mohnsolo/tap-tempo/tap-tempo-schematic.pdf

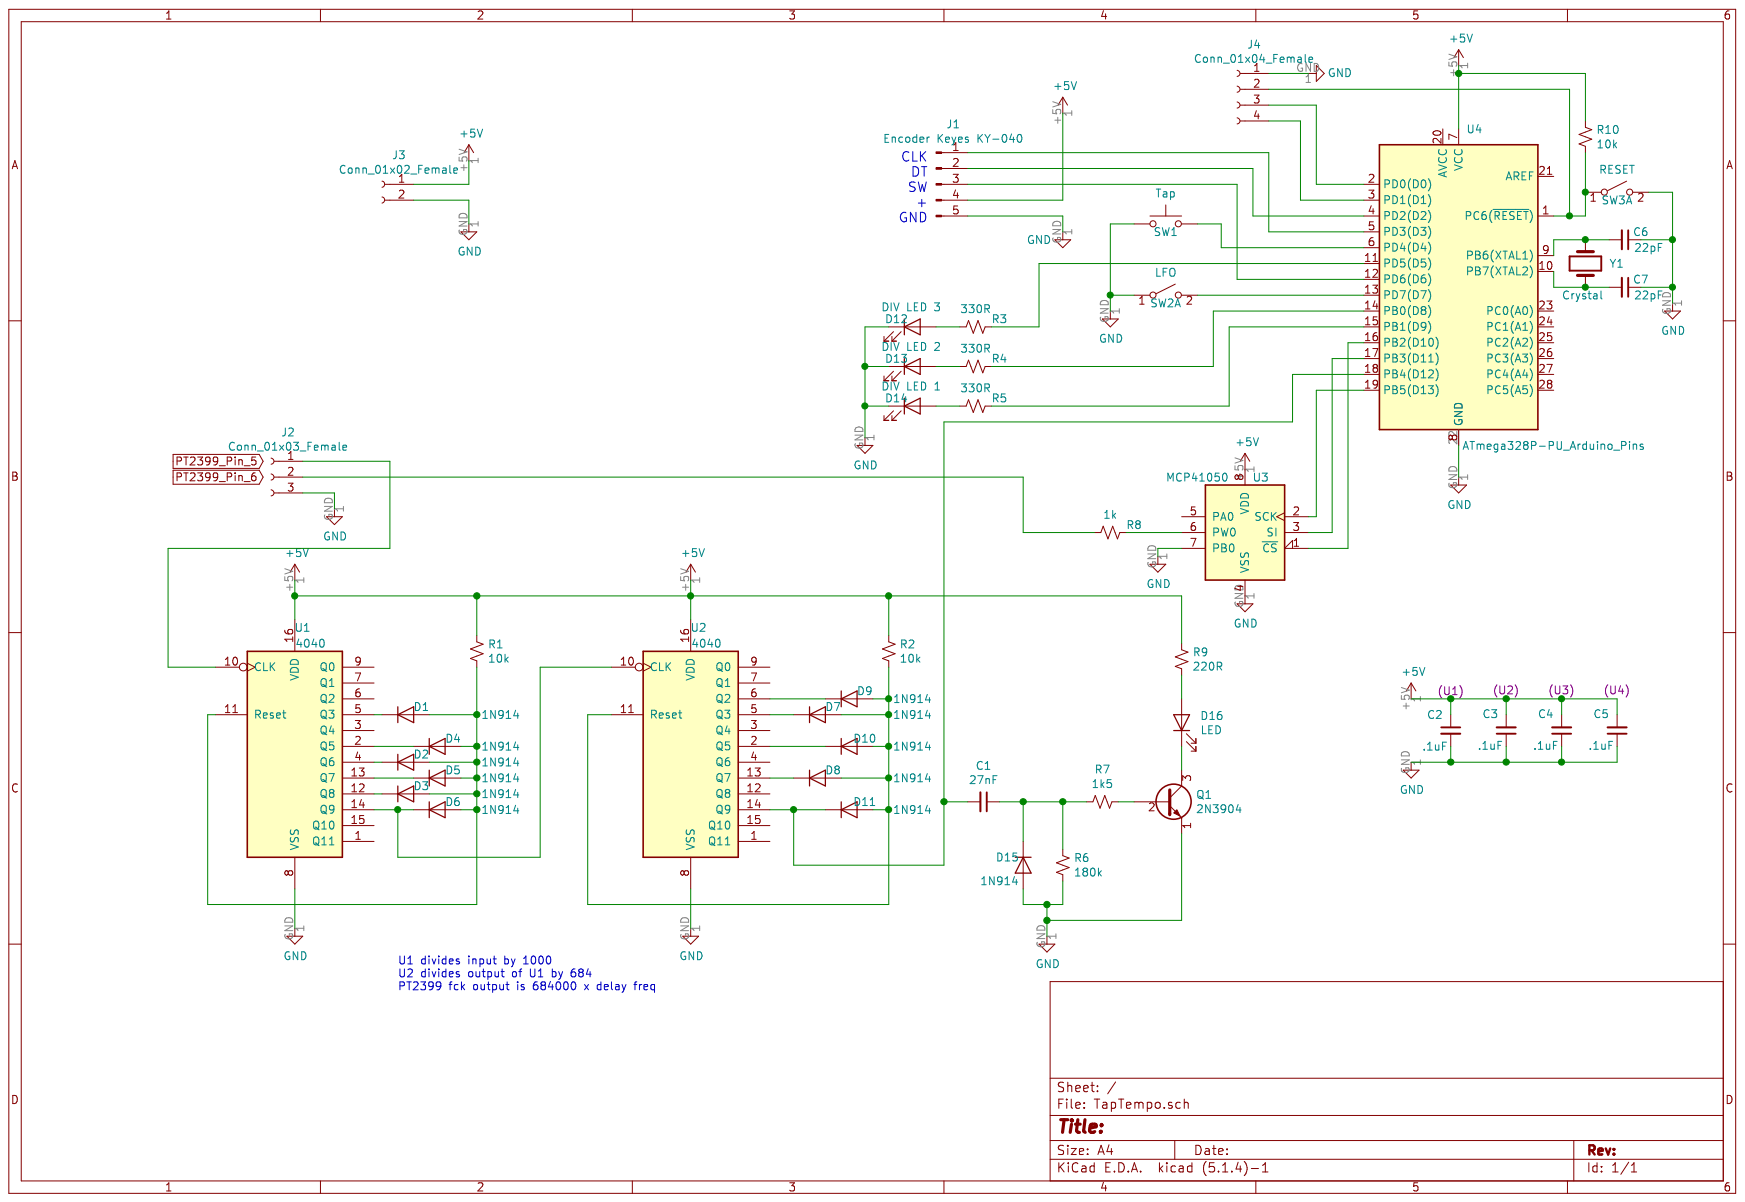
[picture p1: page 1]
