mohnsolo/tap-tempo/(commit log)

2022-08-14 added division LEDs
2022-09-11 Removed magic numbers. Added calibration routine.
2022-10-15 LFO pin pulled LOW is ON
